nicolasgarzione/rocket-league-robot/README.md

# rocket-league-robot
An autonomous soccer-playing robot built in MCEN 5115 Mechatronics and Robotics

CAD: https://grabcad.com/library/autonomous-soccer-robot-1
