nicolasgarzione/rocket-league-robot/RPi/myimports.py

''' Libraries utilized by Python code '''
''' REV 1 '''

from __future__ import print_function
import pixy 
from ctypes import *
from pixy import *
import serial
import time
from time import sleep
import string
import math
from RFM69 import Radio, FREQ_915MHZ
from gpiozero import Button,LED
import RPi.GPIO as GPIO
from threading import Thread
import tkinter as tk
